ADuetrohit/DDR4-UDIMM/docs/PLACEMENT.md

# Component Placement

Every position is worked out from a JEDEC number. The full table (all 206 parts, with the reason for each) is [hardware/placement.csv](../hardware/placement.csv), generated by `tools/gen_placement.py`, which also writes the Altium script `hardware/scripts/DDR4_Placement.pas`. `tools/check_placement.py` compares the PcbDoc against the table.

**Final placement** (after manual fine-tuning in Altium, 2026-09-22) is recorded in [hardware/placement_final.csv](../hardware/placement_final.csv), with each part's distance from the plan; `tools/check_placement.py` checks against it.

Coordinates are in mm from the board origin: bottom-left corner, gold fingers along y = 0, board 133.35 × 31.25.

## What the standard fixes

| JEDEC value (JESD21-C 4.20.26 Annex A, Raw Card A3) | Placement consequence |
|---|---|
| DQ/DQS/DM finger → DRAM ball **11.1–13.7 mm** total (p.9), shortest for bytes 0 and 7, longest for bytes 3 and 4 | Each DRAM sits over its own byte-lane fingers; the four middle DRAMs lean a few mm toward the centre. Data balls (rows A–E) must face the fingers. |
| TL0 finger → 15 Ω resistor **3.1–6.0 mm** (p.9) | 15 Ω resistors directly above their own fingers: front-finger nets at y 5.0, back-finger nets at y 7.5 |
| TL3 DRAM → DRAM on the fly-by **12.8 mm** (p.6, p.10–11) | DRAM pitch 10.93 mm (≤ 12.8 mm, meandered to length) |
| TL4 across the centre (U4 → U5) **46.3 mm** | U4–U5 centre spacing 45.82 mm |
| TL5 last DRAM → termination **13.0 mm** (p.6, p.10–11) | 26 × 39 Ω VTT terminations and the CK0 network next to U8 |
| ALERT_n: pull-up R1 then TL0 **2.5 mm** to the *first* DRAM (p.12; main spec 6.3.7) | R102 beside U1, the first DRAM on the clock chain |
| CK1 finger → 75 Ω **3.7 ± 0.8 mm** (p.7) | R106 directly above the CK1 fingers |
| Main spec Table 9 decoupling | Caps at each DRAM's VPP (B1, M9), VREFCA (J1) and VDD balls; caps at the VTT, VPP and VREFCA fingers; 4 × 4.7 µF bulk |
| MO-309: components ≥ 4.00 mm above the finger edge | nothing below y 4.0 (room `Room_FingerZone`) |
| Annex A general-layout drawing | 4 + 4 DRAMs, SPD at top centre |

## DRAM orientation

The Micron SA footprint has ball A1 at its top-left at 0°, which puts the data rows (A–E) at the top and the address rows (L–N) toward the fingers. At that angle every data net would be about 20 mm, over the 13.7 mm limit. **All eight DRAMs are rotated 180°**, so A1 is at the bottom-right: data rows A–E face the fingers (row A at y 10.5), address/command rows F–N face the top, where the fly-by bus runs.

## Positions

| Byte | DRAM | X | Lane centre | Offset | 15 Ω group centre | ZQ | Caps (VREFCA, VDD, VDD, 1 µF, VPP, VPP) |
|---|---|---|---|---|---|---|---|
| 0 | U1 | 9.30 | 9.3 | 0 | 9.30 | R1 | C1–C6 |
| 1 | U2 | 20.23 | 18.7 | +1.5 | 19.47 | R13 | C7–C12 |
| 2 | U3 | 31.16 | 28.0 | +3.2 | 29.58 | R25 | C13–C18 |
| 3 | U4 | 42.09 | 37.3 | +4.8 | 39.70 | R37 | C19–C24 |
| 4 | U5 | 87.91 | 92.6 | −4.7 | 90.26 | R49 | C25–C30 |
| 5 | U6 | 98.84 | 102.0 | −3.2 | 100.42 | R61 | C31–C36 |
| 6 | U7 | 109.77 | 111.3 | −1.5 | 110.54 | R73 | C37–C42 |
| 7 | U8 | 120.70 | 120.7 | 0 | 120.70 | R85 | C43–C48 |

All DRAMs at y 15.3, rotated 180°. Around each DRAM (after rotation, column 1 on the right, row A at the bottom):

| Part | Position | Ball |
|---|---|---|
| ZQ 240 Ω | x − 4.6, y 11.3 | B9 (keep ≤ 5 pF, so short) |
| VPP 0.1 µF | x + 4.6, y 11.3 | B1 |
| VDD 0.1 µF | x + 4.6, y 14.1 | F1 / E2 side |
| VREFCA 0.1 µF | x + 4.6, y 16.9 | J1 |
| VDD 0.1 µF | x − 4.6, y 15.3 | F9 / J9 side |
| VPP 0.1 µF | x − 4.6, y 19.3 | M9 |
| 1.0 µF VDD | x, y 21.7 | above the DRAM |

Other parts:

| Part | Position | Why |
|---|---|---|
| U9 SPD + C49 | (66.675, 24.0), cap at (69.2, 24.0) | top centre, as in the Annex A drawing |
| R106 CK1 75 Ω | (65.825, 5.2), 0° | across the CK1_t/c fingers (x 65.4 / 66.25) |
| C70 VTT | (68.2, 5.2) | VTT finger x 67.95 |
| C53 VPP | (129.2, 5.2) | VPP fingers x 128.3–130.0 |
| C54 VREFCA | (4.2, 5.2) | VREFCA finger x 4.2 |
| 26 × 39 Ω terminations | two rows of 13 at y 23.2 / 25.6, x 113.0–128.6 | after U8 |
| C57–C69 VTT | row at y 28.0, x 113.0–128.6 | 1 per 2 terminations |
| R115 / R117 / C56 CK0 | (126.0 / 127.3 / 128.6, 20.5) | after U8 |
| R102 ALERT_n 47 Ω | (4.4, 21.2) | pull-up before the first DRAM U1 (ball L9 at x 6.1, y 18.5) |
| C50, C51, C52, C55 bulk | (48.8, 15.3), (81.2, 15.3), (25.0, 25.5), (100.0, 25.5) | spread along the module |

**15 Ω order and rows (revised 2026-09-22).** Each byte's 11 fingers alternate front/back. Every resistor now sits directly above its own finger, in finger order, so no finger-side trace crosses another:

- **Low row, y 5.0:** the 5 nets with **front** fingers (e.g. byte 0: DQ4, DQ0, DM0, DQ6, DQ2), each at its finger's x — a straight trace up on L1.
- **High row, y 7.5:** the 6 nets with **back** fingers (byte 0: DQ5, DQ1, DQS0_C, DQS0_T, DQ7, DQ3), each at its finger's x (in the gaps between the front fingers); the trace comes up from the back through a via between the rows. The DQS pair's back fingers are only 0.85 mm apart, so their resistors are spread to 1.3 mm about the pair's centre.
- **Rotation 270°:** pad 2 (the connector-side net DQn/DQSn/DMn) points down to the fingers, pad 1 (NetRn_1, the DRAM side) up to the DRAM.

On every DRAM sheet R(12k+2) … R(12k+12) carry DQ0, DQ1, DQ2, DQ3, DQ4, DQ6, DQ7, DQS_t, DQS_c, DM, DQ5 of byte k (`RES_ROLE` in `tools/gen_placement.py`). The first plan grouped the 11 resistors in two rows by designator, which put them in a different order from their fingers (for byte 0, DQ4's finger is leftmost but R6 was near the right), and at 90°, which faced the wrong pad down. `hardware/scripts/DDR4_DataResistors.PrjScr` moves only these 88 resistors.

## Final placement vs the plan

Manual fine-tuning kept everything the standard fixes: the eight DRAMs (positions and 180° rotation), the SPD and all 88 × 15 Ω resistors are exactly as planned. The rest moved only a little:

| Parts | Move | Still meets |
|---|---|---|
| DRAM side caps and ZQ resistors | 0.3–1.9 mm | beside their balls (Table 9; ZQ short) |
| 1 µF caps above the DRAMs | ≈ 2 mm sideways | above their DRAM |
| 26 terminations + 13 VTT caps | up 0.7–1.3 mm | after U8, inside TL5 |
| C49 (SPD) | to the other side of U9 | next to U9 |

Nothing is on the bottom side and nothing is below y 4.3 mm.
