ADuetrohit/DDR4-UDIMM/(list of files, drawings)

Other design files:
hardware/project/DDR4-UDIMM — 16 GB DDR4.PcbDoc
hardware/project/DDR4-UDIMM — 16 GB DDR4.PrjPcb
hardware/project/edge.SchDoc
hardware/project/micron_P2.SchDoc
hardware/project/micron_P3.SchDoc
hardware/project/micron_P4.SchDoc
hardware/project/micron_P5.SchDoc
hardware/project/micron_P6.SchDoc
hardware/project/micron_P7.SchDoc
hardware/project/micron_P8.SchDoc
hardware/project/micron_ram.SchDoc
hardware/project/SPD.SchDoc
hardware/project/TERM.SchDoc
