ADuetrohit/DDR4-UDIMM/(commit log)

2026-09-17 Initial project setup: DDR4-3200 16 GB UDIMM
    - Locked specification: 288-pin UDIMM (MO-309), JEDEC Raw Card A3,
    8x 16Gb x8 DRAM, 1 rank, non-ECC, 8-layer 1.40 mm PCB
    - BOM v1 with exact MPNs and Digi-Key part numbers
    - Design notes: stackup, impedance targets, resistor values,
    decoupling rules and routing lengths from JESD21-C 4.20.26 + Annex A
    - Reference source list (copyrighted PDFs kept local, gitignored)
    - PDF page render helper for image-only JEDEC drawings
    [BOM_v1.csv]
2026-09-17 Add official CAD model sources and vendor library folder
    - docs/CAD_MODELS.md: official symbol/footprint/3D source per BOM part
    - DRAM AS4C2G8D4A-62BCN has no vendor model; IPC-7351 BGA footprint
    plan from the Alliance datasheet package drawing
    - hardware/libraries/vendor/: folder layout for downloaded models
    - README: progress and changelog updated
2026-09-17 BOM v2: switch DRAM to Micron MT40A2G8SA-062E:F
    The Alliance AS4C2G8D4A-62BCN has no official CAD model anywhere.
    The Micron MT40A2G8SA-062E:F (16Gb x8, DDR4-3200 CL22, 78-ball SA
    7.5x11 mm) is Active at Digi-Key and uses the same SA package as the
    Ultra Librarian built & verified model for MT40A2G8SA-062E IT:F.
    - bom/BOM_v2.csv added (v1 kept for history)
    - CAD_MODELS.md: DRAM model source + Micron Figure 9 check values
    - DESIGN_NOTES.md: DRAM decision, ball notes verified from Micron
    Figure 5 (VPP B1/M9, VREFCA J1, ZQ B9, TEN G9, A17 N7 NC)
    - SOURCES.md: Micron 16Gb DDR4 datasheet Rev H added
    - README: spec, BOM link and changelog updated
    [BOM_v2.csv]
2026-09-17 docs: add Micron 16Gb DDR4 datasheet page map
    Lists the datasheet pages each design step uses: pinout, ball
    descriptions, SA package, power, IDD limits, package electricals,
    and the speed-bin and AC-timing tables for SPD programming.
2026-09-17 docs: DRAM electrical rules, current budget and SPD timings; fix 15R count
    From the Micron Rev H pages in use:
    - Power rules (VPP >= VDD, VREFCA = VDD/2), TEN tie-low requirement,
    ZQ 240R to VSSQ with 5pF max load, NF/NC and unused-pin handling
    - Current budget: 8x IDD7 = ~1.34 A on VDD, ~50 mA on VPP
    - SPD timing table for Annex L (CL22, tRFC1 350 ns, tREFI 7.8 us, ...)
    - 15 ohm series resistor count corrected 80 -> 88 (adds 8 DM lines)
    [BOM_v2.csv]
2026-09-18 Add DRAM sheet specification and BOM v3 with exact quantities
    docs/SCHEMATIC_DRAM.md: how one MT40A2G8SA-062E:F is wired -
    per-chip passives with MPNs, power/ground map, data byte with the
    15 ohm series resistors at the card edge, shared CA bus with 39 ohm
    VTT termination, clock termination (39/39 + 0.01uF to VDD), 75 ohm
    unused clock, 47 ohm ALERT_n, and the pins left open (TEN tied low).
    Verified from the standards: VTT and VREFCA decoupling returns to VDD
    (not VSS) per Table 9, and R1 sits near the card edge per the Annex A
    data net structure.
    bom/BOM_v3.csv: exact quantities (88x 15R, 28x 39R, 57x 100nF, ...)
    [BOM_v3.csv]
2026-09-18 docs: clarify the DRAM power section
    Redraw the power/ground diagram so each capacitor is shown as a
    separate two-leg part, and add a table explaining VDD/VDDQ/VSS/VSSQ/
    VPP/VREFCA with their voltages and balls.
2026-09-18 docs: add an Altium-sheet view of the DRAM wiring
    Shows U1B with a power port on every pin, the six capacitors drawn as
    two-pin parts between ports, and U1A with the ZQ resistor, TEN tied to
    GND, and the series resistors plus net labels on the data pins.
2026-09-18 tools: Altium SchDoc netlist extractor and DRAM wiring checker
    schdoc_nets.py reads a binary .SchDoc (components, pins of the placed
    part and display mode, wires, junctions, net labels, power ports) and
    joins them geometrically into nets.
    check_dram.py checks every MT40A2G8SA DRAM against the spec: 30 shared
    CA/CTRL nets, 31 power/ground pins, 5 no-connects, ZQ via 240R to GND,
    the 11 data pins via 15R to one consistent byte, per-chip decoupling
    totals, and multi-name nets (shorts).
    Validated on schematic history: it flags the earlier VPP/VREFCA-on-VDD
    and missing-decoupling errors. Current U1 sheet passes 83/83.
2026-09-18 README: all 8 DRAM sheets wired and verified (636/636)
2026-09-18 Edge connector: JEDEC 288-pin table, Symbol Wizard files, and ALERT_n fix
    tools/gen_edge_connector.py holds JESD21-C 4.20.26 Table 5 (UDIMM
    functions), maps every pin to this design's net names, self-checks that
    every DQ/DQS/DM/CA/CTRL/SPD net appears exactly once, and cross-checks
    against the Micron CT8G4DFS8 table (286/288 automatic; 263/264 are a
    PDF text-layout artifact, verified by eye).
    Outputs in hardware/libraries/edge_connector/: the full pinout CSV and
    five paste-ready Symbol Wizard TSVs (A/B data, C addr/cmd/clk/SPD,
    D ground, E power + unused). docs/SCHEMATIC_CONNECTOR.md is the guide.
    Fix: Annex A shows the ALERT_n 47 ohm as a pull-up to VDD at the far
    end of the fly-by chain,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
2026-09-18 Symbol Wizard TSVs: write with CRLF line endings
    Altium's Pin Data Smart Paste splits rows on Windows line breaks, so the
    generator now writes CRLF and .gitattributes keeps *.tsv as CRLF on
    checkout.
2026-09-18 Add edge-connector symbol library and SchLib pin checker
    hardware/libraries/DDR4_UDIMM.SchLib: the 288-pin DDR4 UDIMM edge
    connector as one component with 5 parts (A/B data, C addr/cmd/clk/SPD,
    D ground, E power + unused), built with Altium's Symbol Wizard.
    tools/check_edge_symbol.py decodes Altium's binary pin records and
    checks all 288 pins (number, name, part, electrical type, side,
    description) against the generated TSVs: 288/288 pass. Negative test
    (pin 59 changed to 58) is caught.
2026-09-18 tools: EDGE sheet connector checker; label lists per symbol column
    check_connector.py checks all 288 connector pins on the EDGE sheet
    against the JEDEC pinout CSV: expected net label / power port name,
    unused pins unconnected with a No-ERC mark, shorts (multi-name nets)
    and Altium default 'NetLabelN' names. First run: 275/288 correct.
    hardware/libraries/edge_connector/labels/: top-to-bottom net-label
    lists per symbol column, derived from the saved SchLib pin geometry.
2026-09-18 docs: verified Altium placement tips for the EDGE sheet
    From a documentation check: Tab-before-first-click auto-increment
    (suffix numbers only), Ctrl+R is Edit > Duplicate (no 'Rubber Stamp'
    menu item), open Smart Paste from the menu (Shift+Ctrl+V is also the
    equal-vertical-spacing shortcut), Paste Array settings for identical
    power-port columns, and that text-list-to-net-label paste is unverified.
2026-09-18 tools: No-ERC markers apply to the whole net they touch
    schdoc_nets.py now attaches Generic No ERC markers to the wire or pin
    they sit on and flags the net; check_connector.py accepts a marker
    anywhere on an unused pin's stub, matching Altium's behaviour. DRAM
    check unchanged (636/636).
2026-09-18 docs: SPD and termination sheet specifications
    SPD: 34AA04T-I/MUY pinout (A0-A2 = SA0-SA2, SDA, SCL, VCC = VDDSPD,
    VSS + exposed pad = GND, pin 7 NC) with a 0.1 uF VDDSPD cap.
    TERM: 26x 39R to VTT, 14x 0.1uF VTT-to-VDD, CK0 39R/39R + 0.01uF to VDD,
    75R across CK1, 47R ALERT_n pull-up to VDD, card-edge VPP/VREFCA caps,
    4x 4.7uF bulk. Totals reconcile with BOM v3.
2026-09-18 SPD sheet verified; add 34AA04T-I/MUY vendor model
    The SPD sheet checks clean: A0-A2 = SA0-SA2, SDA, SCL, VCC = VDDSPD,
    VSS = GND, pin 7 NC with No-ERC, 0.1 uF VDDSPD cap, no shorts.
    Ultra Librarian model (SchLib, PcbLib, LibPkg, STEP) stored under
    hardware/libraries/Altium/ where the project links it. Its footprint
    has 8 pads; Microchip's UDFN land pattern marks the center pad as
    optional and the datasheet allows it to float.
2026-09-19 BOM v4: approved alternate for the 4.7 uF bulk capacitor
    TDK C1608X5R1C475K080AC (4.7 uF 16 V X5R 0603, 0.90 mm max, Active,
    Digi-Key 445-7478-1-ND, CAD models listed) as a drop-in alternate for
    Samsung CL10A475KO8NNNC. Checked alternatives that failed: Murata
    GRM188R61C475KAAJ (no longer carried by Digi-Key) and TDK
    C1608X5R1A475K080AC (obsolete).
    [BOM_v4.csv]
2026-09-19 tools: termination sheet checker
    check_term.py verifies TERM.SchDoc: exactly one 39R from each of the 26
    CA/CTRL nets to VTT, CK0 39R/39R into a node with 0.01uF to VDD, 75R
    across CK1, 47R ALERT_n pull-up to VDD, 14x VTT-VDD, VPP-GND and
    VREFCA-VDD 0.1uF caps, 4x 4.7uF VDD-GND bulk, and flags any cap on the
    wrong rails. First run: resistors all correct; VTT/VREFCA caps on GND
    and only one bulk cap.
2026-09-19 Schematic complete: TERM sheet verified, whole-project checker added
    tools/check_project.py merges nets by name across every sheet, flags
    named nets reaching fewer than 2 pins, dangling pins without No-ERC,
    and multi-name nets, and compares part counts with the latest BOM.
    Final run on all 11 sheets: 131 nets, 0 failures, 0 warnings; all 11
    BOM v4 lines match the schematic exactly. DRAM 636/636, EDGE 288/288,
    TERM pass, connector symbol 288/288.
2026-09-19 Gold-finger footprint + board outline from MO-309F
    - tools/gen_edge_footprint.py: single source for the 288-pad geometry (step/ramp
    zones, off-centre key at 72.25), 40-segment outline with key and latch notches,
    and finger mask windows; writes the pad CSV and an Altium DelphiScript
    - hardware/scripts/DDR4_Edge_Footprint.pas: builds DDR4_UDIMM_288_MO309 in a PcbLib
    - tools/pcblib.py: PcbLib reader (pads, tracks, arcs, fills)
    - tools/check_edge_footprint.py: verifies the saved footprint and the symbol link
    - docs/FOOTPRINT_EDGE.md: dimensioned drawings, Altium steps, fab notes
2026-09-19 Add script project for the edge-footprint script
    File > Run Script > Browse only opens .PrjScr files, so the generator now
    also writes DDR4_Edge_Footprint.PrjScr wrapping the .pas; build steps updated.
2026-09-19 Edge-footprint script: use footprint-local coordinates
    Adding Lib.Board.XOrigin/YOrigin shifted every primitive by 1270 mm from the
    footprint origin (found by check_edge_footprint.py on the first build).
2026-09-19 DDR4_UDIMM.PcbLib: gold-finger footprint built and verified
    DDR4_UDIMM_288_MO309 passes check_edge_footprint.py: 288 pads (position, layer,
    size, SMD, no paste), 31 lines + 9 arcs of outline, 4 solder-mask windows.
2026-09-19 Link DDR4 edge connector to gold-finger footprint
2026-09-19 Document final schematic ERC review
2026-09-20 Add Altium project and verified DDR4 board shape
    [DDR4-UDIMM — 16 GB DDR4.PcbDoc, DDR4-UDIMM — 16 GB DDR4.PrjPcb, SPD.SchDoc, TERM.SchDoc, edge.SchDoc, micron_P2.SchDoc, micron_P3.SchDoc, micron_P4.SchDoc]
2026-09-21 Stackup and impedance profiles in the PcbDoc; add stackup checker
    - 8-layer Annex A stack (70/80/420/80/420/80/70 um), 1.398 mm without mask
    - Six impedance profiles: SE_50/55/40, DIFF_83/93/70, solved on L1/L3/L5/L6/L8
    - All 206 schematic parts imported to the PCB (placement next)
    - tools/check_stackup.py: checks stack, thickness, profiles and reference planes
    - Docs: as-built widths, inner-layer 0.075 mm minimum note, open items
    [DDR4-UDIMM — 16 GB DDR4.PcbDoc]
2026-09-21 Stackup verified; sync PcbDoc with net classes and clearance rules
    - L6 single-ended impedance references moved from L5 to L4
    - SE_55 and DIFF_93 limited to L1/L8 (inner widths under 0.075 mm)
    - check_stackup.py: also flags widths under the 0.075 mm Annex A minimum; PASS
    - PcbDoc synced from the Altium working copy: 19 net classes (BYTE0-7,
    DQ, DQS, DM, DATA, ADDR, CTRL, CK, CK_UNUSED, RESET, ALERT, POWER)
    and 9 clearance rules
    - README and design notes: as-built widths, references, new open items
    [DDR4-UDIMM — 16 GB DDR4.PcbDoc, DDR4-UDIMM — 16 GB DDR4.PrjPcb]
2026-09-21 Stackup Dk 4.2 to match Annex A widths; start placement
    - Dielectric Dk 4.8 -> 4.2: 50/55/40 ohm now solve to ~0.10/0.078/0.15 mm on L3,
    matching the Annex A fabrication table
    - SE_55 re-enabled on L3/L5/L6 and DIFF_93 on L6, as Annex A specifies
    - check_stackup.py: small under-minimum widths are warnings (routed at 0.075 mm)
    - Placement: U1-U8, U9 and the 88 series resistors on the board
    - 21 net classes; ComponentClearance off, pad-to-pad ignored inside footprints
    - README and design notes updated
    [DDR4-UDIMM — 16 GB DDR4.PcbDoc]
2026-09-21 Design rules Blocks 1-2: clearances and width rules; add rules checker
    - Clearance_LineToShape re-created (IsTrack / InPolygon, 0.20 mm)
    - Width rules from the Annex A table: POWER 0.3, CK 0.075, ADDR/CTRL 0.075,
    DATA 0.10, SPD 0.15, default 0.10; minimum 0.075 mm everywhere
    - tools/check_rules.py: checks rule scopes, values, enabled state, priorities
    - Design notes: new section 10 (PCB design rules); README progress and checks
    [DDR4-UDIMM — 16 GB DDR4.PcbDoc]
2026-09-21 Design rules Block 3: differential pairs and diff-pair routing rules
    - 18 pairs: CK0, CK1, DQS0-7 and DQS0_DRAM-DQS7_DRAM (DRAM side of the
    15 ohm resistors, NetR(12n+9)_1 / NetR(12n+10)_1)
    - Pair classes DP_DQS (16) and DP_CK (2)
    - DiffPair_DQS 0.10/0.10, DiffPair_CK 0.075/0.10 (max 0.15), default rule;
    gap 0.10-0.127 mm, 3 mm max uncoupled length
    - check_rules.py: checks every pair's nets and per-layer diff-pair widths
    [DDR4-UDIMM — 16 GB DDR4.PcbDoc]
2026-09-21 Design rules Block 4: routing layers per net class
    - New net class DATA_DRAM: the 88 resistor-to-DRAM data nets (no ZQ nets)
    - Width_DATA now covers DATA and DATA_DRAM
    - Routing layers from the Annex A layer table: DATA L1/L3/L8, CK L1/L6/L8,
    ADDR/CTRL L1/L3/L5/L6/L8, POWER all; L2/L4/L7 left for planes
    - check_rules.py: checks routing layers and the DATA_DRAM class (PASS)
    [DDR4-UDIMM — 16 GB DDR4.PcbDoc]
2026-09-21 Design rules Block 5: via styles, BGA fanout, hole and annular ring
    - Signal vias 0.40/0.20 mm (max 0.45 to fit between 0.8 mm-pitch DRAM balls)
    - POWER vias 0.50/0.25 mm
    - Fanout_BGA centred between pads; hole size 0.2-0.3 mm; annular ring 0.1 mm
    - DRAM pad grid verified from the PcbDoc: 78 x 0.34 mm pads, 0.8 mm pitch
    - check_rules.py: Block 5 checks; warns on rule names with stray spaces
    [DDR4-UDIMM — 16 GB DDR4.PcbDoc]
2026-09-21 Design rules Block 6: polygon connect styles and pour clearance
    - Vias connect directly to pours; pads use 4-spoke 0.2/0.2 mm thermal relief
    - Clearance_LineToShape widened to any object vs polygon copper (0.2 mm)
    - check_rules.py: Block 6 checks (PASS)
    [DDR4-UDIMM — 16 GB DDR4.PcbDoc]
2026-09-21 Design rules Block 7: height, top-side-only and finger-zone room
    - Height <= 1.2 mm (preferred 1.0) for the single-sided module
    - PermittedLayers_TopOnly: parts on the top side only
    - Room_FingerZone: every part except J1 kept out of y 0-4.0 mm (MO-309)
    - check_rules.py: Block 7 checks, including the room polygon (PASS)
    [DDR4-UDIMM — 16 GB DDR4.PcbDoc]
2026-09-21 Placement plan from Annex A and Table 9, with Altium placement script
    - tools/gen_placement.py: all 206 parts from JEDEC numbers (data-net length
    11.1-13.7 mm, TL3 12.8, TL4 46.3, TL5 13.0, CK1 TL0 3.7, Table 9 decoupling)
    - DRAMs over their byte lanes at 10.93 mm pitch, rotated 180 deg so ball rows
    A-E (data) face the fingers
    - hardware/placement.csv and hardware/scripts/DDR4_Placement.pas (+ .PrjScr)
    - tools/check_placement.py: compares the PcbDoc with placement.csv
    - docs/PLACEMENT.md: derivation and position tables
    [placement.csv]
2026-09-21 Placement complete: all 206 parts at the JEDEC-derived positions
    - DDR4_Placement script run in Altium; check_placement.py 206/206
    - DRAMs over their byte lanes, rotated 180 deg; terminations, CK0 and ALERT
    networks after U8; decoupling at the DRAM balls and power fingers
    - Rules and stackup checks still PASS
    - PLACEMENT.md: VPP cap at ball M9 is at y 19.3
    [DDR4-UDIMM — 16 GB DDR4.PcbDoc]
2026-09-21 Placement finalised by hand and recorded as placement_final.csv
    - Caps and terminations nudged up to 2 mm, C49 moved beside U9; DRAMs,
    SPD and all 15 ohm resistors unchanged from the JEDEC plan
    - check_placement.py: --export records as-placed positions (with the
    distance from the plan); checks against the final table by default
    - PLACEMENT.md: final-vs-plan summary; rules and stackup still PASS
    [DDR4-UDIMM — 16 GB DDR4.PcbDoc, placement_final.csv]
2026-09-21 Correct ALERT_n pull-up location; record JEDEC length-matching rules
    - R102 (47 ohm ALERT_n pull-up) goes before the first DRAM U1, TL0 2.5 mm
    (Annex A p.12, main spec 6.3.7), not after U8: plan, PLACEMENT.md,
    DESIGN_NOTES and SCHEMATIC_SUPPORT corrected
    - Design notes: main spec Tables 10-12, 14 and higher-speed rules (6.4)
    for Block 8 length matching
    [placement.csv]
2026-09-21 R102 beside U1; power via to JEDEC 0.45/0.25 mm; re-record final placement
    - ALERT_n pull-up R102 now before the first DRAM (4.32, 20.96)
    - RoutingVias_POWER 0.40/0.45/0.45 mm, hole 0.25 (Table 14 large via)
    - placement_final.csv re-exported; placement, rules and stackup PASS
    [DDR4-UDIMM — 16 GB DDR4.PcbDoc, placement_final.csv]
2026-09-21 Block 8 part 1: address/command/clock xSignals and matched-length rules
    - xSignal Multi-Chip Wizard (DDR4), J1 -> U1 ... U8 fly-by
    - ADDR_PP1-8: 28 xSignals each (A0-A13, A15_CAS, A16_RAS, ACT, BA0/1,
    BG0/1, CK0_T/C, CKE, CS, ODT, PAR, WE)
    - Matched length 1.0 mm per DRAM; CK pair 0.1 mm
    - Docs: how the wizard was driven and what it misses
    [DDR4-UDIMM — 16 GB DDR4.PcbDoc]
2026-09-21 Block 8: data-lane xSignal attempts; plan split-segment byte matching
    - Altium's xSignal tools don't trace through the 15 ohm resistors here;
    two wrong test xSignals removed (file clean, 8 ADDR classes intact)
    - Plan: match finger-side (BYTEn) and DRAM-side (BYTEn_DRAM) halves each
    within 0.5 mm, keeping DQ/DM within DQS +/- 1.0 mm (Table 11)
    - Rules, stackup and placement checks PASS
    [DDR4-UDIMM — 16 GB DDR4.PcbDoc]
2026-09-22 Block 8: BYTE0_DRAM-BYTE7_DRAM net classes
    - DRAM side of each byte's 11 x 15 ohm series resistors,
    NetR(12k+2)_1 ... NetR(12k+12)_1, for split-segment byte matching
    - check_rules.py verifies all eight classes (PASS)
    [DDR4-UDIMM — 16 GB DDR4.PcbDoc]
2026-09-22 Block 8: byte-lane matched-length rules (16 x 0.5 mm)
    - ML_BYTE0-7 (finger -> 15 ohm) and ML_BYTE0_DRAM-7_DRAM (15 ohm -> DRAM),
    group matched within 0.5 mm, so DQ/DM stay within DQS +/- 1.0 mm
    - check_rules.py checks all 16 (caught ML_BYTE2 pointing at BYTE5, fixed)
    [DDR4-UDIMM — 16 GB DDR4.PcbDoc]
2026-09-22 Design rules complete: DQS pair matching 0.1 mm
    - ML_DQS_PAIRS: diff pair class DP_DQS, within-pair length 0.1 mm (Table 11)
    - Blocks 0-8 done; check_rules.py, check_stackup.py, check_placement.py PASS
    [DDR4-UDIMM — 16 GB DDR4.PcbDoc]
2026-09-22 L4 VDD plane poured; L2/L7 splits deferred until after routing
    - L4_VDD_POUR: VDD, (0,1)-(133.35,31.25), solid, 3948.7 mm2, clipped to
    the notches; 1 mm clear of the bevelled finger edge
    - Remove Dead Copper off until VDD vias exist (else Altium deletes it)
    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
    [DDR4-UDIMM — 16 GB DDR4.PcbDoc]
2026-09-22 Routing: BGA fan-out of all eight DRAMs
    - 408 vias, 51 per DRAM in an identical dog-bone pattern (42 signal
    0.40/0.20 mm, 9 power 0.45/0.25 mm), centred between balls
    - Fanout_BGA re-scoped to HasFootprint('SA_MFG'); IsBGA matched nothing
    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
    [DDR4-UDIMM — 16 GB DDR4.PcbDoc]
2026-09-22 Tent all vias; first full DRC after fan-out
    - SolderMask_TentedVias (IsVia, tented top/bottom) clears 2809 mask
    slivers between fan-out vias and DRAM balls
    - DRC: no shorts, clearance, width or length errors; remaining items are
    expected while unrouted or cosmetic silkscreen
    - check_rules.py covers the tenting rule (PASS)
    [DDR4-UDIMM — 16 GB DDR4.PcbDoc]
2026-09-22 Flip the 88 data resistors to 270 deg (finger-side pad toward the fingers)
    - Pad 2 (DQ/DQS/DM) now faces the gold fingers, pad 1 (NetRn_1) the DRAM;
    verified pad-by-pad from the PcbDoc
    - gen_placement.py: RES_ROT = 270; placement.csv, the Altium script and
    placement_final.csv regenerated; placement, rules and stackup PASS
    [DDR4-UDIMM — 16 GB DDR4.PcbDoc, placement.csv, placement_final.csv]
2026-09-22 First routed trace (DQ0 finger -> R2) and a length checker
    - DQ0: 3.24 mm on L1 at 0.10 mm, inside Annex A TL0 for byte 0 (3.2-3.6 mm)
    - tools/check_lengths.py: per-net routed length, width, layers and the
    JEDEC compensated length (outer layers / 1.1)
    [DDR4-UDIMM — 16 GB DDR4.PcbDoc]
2026-09-22 Re-plan data resistors above their own fingers, in finger order
    - Front-finger nets in the low row (y 5.0) at the finger x, back-finger
    nets in the high row (y 7.5) in the gaps; DQS pair spread to 1.3 mm
    - Resistor order now matches finger order in every byte, so no
    finger-side trace crosses another
    - gen_placement.py: RES_ROLE map + finger tables; writes a resistor-only
    script DDR4_DataResistors.PrjScr; no overlaps with the final placement
    [placement.csv]
2026-09-22 Data resistors moved to finger-ordered positions (88/88 verified); re-record final placement
    [DDR4-UDIMM — 16 GB DDR4.PcbDoc, placement_final.csv]
2026-09-22 Route the 40 front-finger data traces (finger -> 15 ohm, L1, 0.10 mm, 2.95-3.20 mm)
    [DDR4-UDIMM — 16 GB DDR4.PcbDoc]
2026-09-22 Route first back-finger data traces (DQ5, DQ1, DQS0 pair) via L8 -> via -> L1
    [DDR4-UDIMM — 16 GB DDR4.PcbDoc]
2026-09-22 Route 47 of 48 back-finger data traces; DQS pairs matched within 0.042 mm
    [DDR4-UDIMM — 16 GB DDR4.PcbDoc]
2026-09-22 Finger side of all eight byte lanes routed (88/88)
    [DDR4-UDIMM — 16 GB DDR4.PcbDoc]
2026-09-22 DRAM side of byte 0 started: DM0, DQ1, DQ2, DQ5, DQS0 pair (L1/L3)
    [DDR4-UDIMM — 16 GB DDR4.PcbDoc]
2026-09-22 DQS0 pair matched: 0.331 mm bump on DQS0_C by script
    - hardware/scripts/DQS0_C_LengthFix.pas (+ .PrjScr): replaces one straight
    L3 piece of NetR10_1 with the same piece plus a 0.1655 x 0.4 mm bump
    - DRAM-side halves now 6.615 / 6.614 mm, full paths 12.158 / 12.157 mm
    - Placement, rules and stackup checks PASS
    [DDR4-UDIMM — 16 GB DDR4.PcbDoc]
2026-09-22 DQS0_C skew bump redrawn with 45-degree chamfers
    - hardware/scripts/DQS0_C_Bump45.pas (+ .PrjScr): same +0.331 mm, every
    corner 135 deg; pair halves 6.615 / 6.614 mm
    - Design notes: length-tuning style (mitered, 0.4 mm amplitude, 0.3 mm
    spacing) and why pair skew is fixed where the lines separate
    [DDR4-UDIMM — 16 GB DDR4.PcbDoc]
2026-09-22 Byte 0 DRAM side: DQ6 and DQ2 routed (L1 -> L3); 7 of 11 done
    [DDR4-UDIMM — 16 GB DDR4.PcbDoc]
2026-09-22 Add DRAM-side router; document crossing-length finding and bit-swap proposal
    - tools/route_dram_side.py: grid router (0/45/90 deg, clearance margin,
    through vias checked on all layers) that writes an Altium script
    - Routing U1's DQ0/DQ3/DQ4/DQ7 across the byte gives 12.9-20.5 mm vs the
    ~11.2-13.2 mm JEDEC window, so no script is applied; a nibble bit swap
    (DQ0<->DQ3, DQ4<->DQ7) is proposed for the author's decision
    - Notes that the per-half matched-length rules can't hold and will be
    replaced by total-length checks
2026-09-22 Add DQS skew-fix tool and script for five pairs; exact clearances in router
    - tools/fix_pair_skew.py: finds a straight piece of the shorter DQS half with
    room (sliding along it) and writes 45-degree bump(s) of 0.3305 mm each
    - hardware/scripts/DQS_SkewFix.pas: DQS1, DQS3, DQS4, DQS5, DQS7 (+0.331 mm)
    - route_dram_side.py: per-rule clearances (track-pad 0.125, via-pad 0.15,
    via-DRAM ball 0.175)
    - DQS2 (1.74 mm apart) needs a re-route; DQS6 has no straight piece with room
2026-09-22 DQS skew bumps applied: six of eight pairs matched to ~0.001 mm
    [DDR4-UDIMM — 16 GB DDR4.PcbDoc]
2026-09-22 Byte 0 fully connected (11/11); record the stretch-to-match strategy
    - U1_Crossers.pas routed DQ0/DQ3/DQ4 (L8) and DQ7 (L3)
    - Totals 9.95-17.66 mm; target = DQ3 17.66 mm, ~48 mm of tuning to add
    - Notes: keep JEDEC bit order, tune up to the longest; meander space is the
    empty corridor down the middle of each DRAM plus the band above the resistors
    [DDR4-UDIMM — 16 GB DDR4.PcbDoc]
2026-09-22 Byte 0 tuning: DQ7 done, Rounded serpentine style, per-net tuning targets
    [DDR4-UDIMM — 16 GB DDR4.PcbDoc]
2026-09-23 Add PcbDoc-to-PNG renderer and board images
2026-09-23 Skew tool: bump height solved from the exact skew; DQS2 fix script
    [DDR4-UDIMM — 16 GB DDR4.PcbDoc]
2026-09-23 Byte 0: 11 full-path xSignals created from J1 to U1
    [DDR4-UDIMM — 16 GB DDR4.PcbDoc]
2026-09-23 Byte 0: BYTE0_FULL xSignal class with all 11 full-path signals
    [DDR4-UDIMM — 16 GB DDR4.PcbDoc]
2026-09-23 Byte 0: ML_BYTE0_FULL total-length rule replaces the half-matching rules
    [DDR4-UDIMM — 16 GB DDR4.PcbDoc]
2026-09-23 Add per-byte status tool; byte 1 DQ13 routed
    [DDR4-UDIMM — 16 GB DDR4.PcbDoc]
2026-09-25 README: add rendered board screenshots
2026-09-25 Remove generated board renders from the README
